ktortop/Lightmeter/PCB Layout/docs/render_3d.png

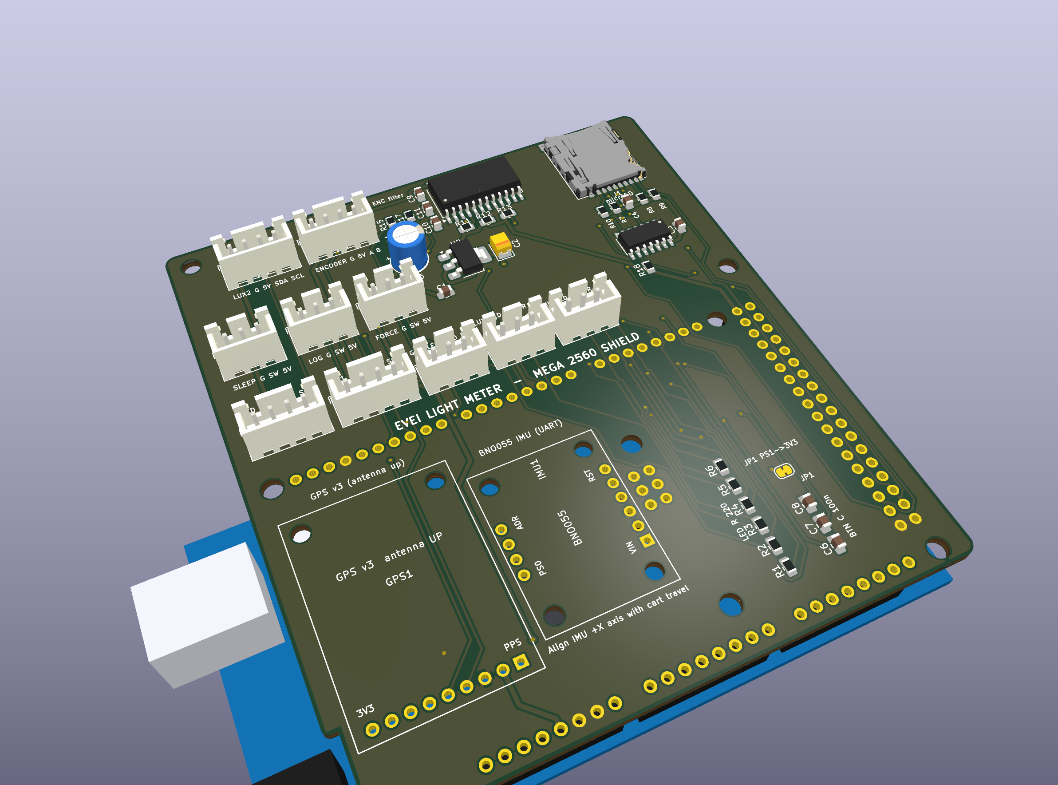
PCB Layout/docs/render_3d.png
