ktortop/Lightmeter/PCB Layout/docs/render_3d_bottom.png

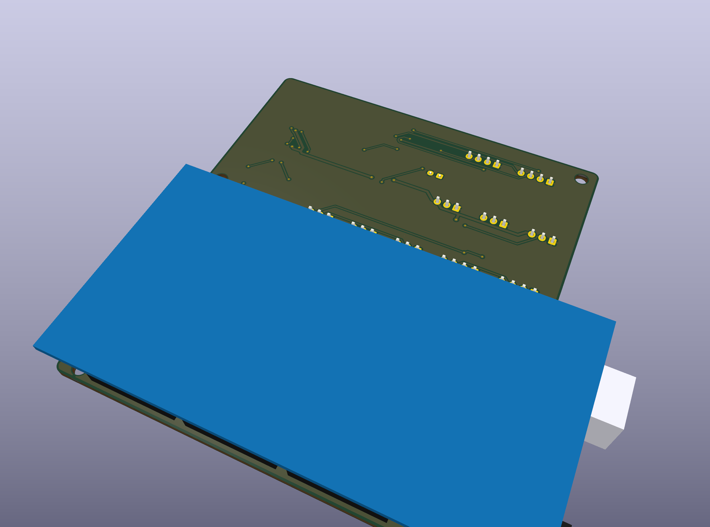
PCB Layout/docs/render_3d_bottom.png
