ktortop/Lightmeter/PCB Layout/docs/render_bottom.png

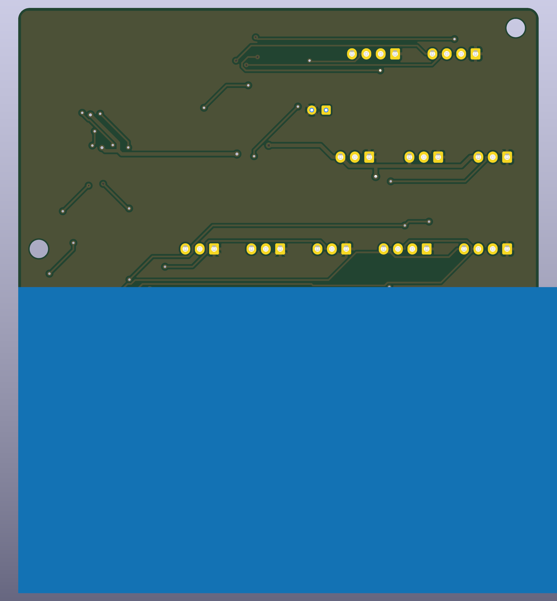
PCB Layout/docs/render_bottom.png
