ktortop/Lightmeter/PCB Layout/docs/render_top.png

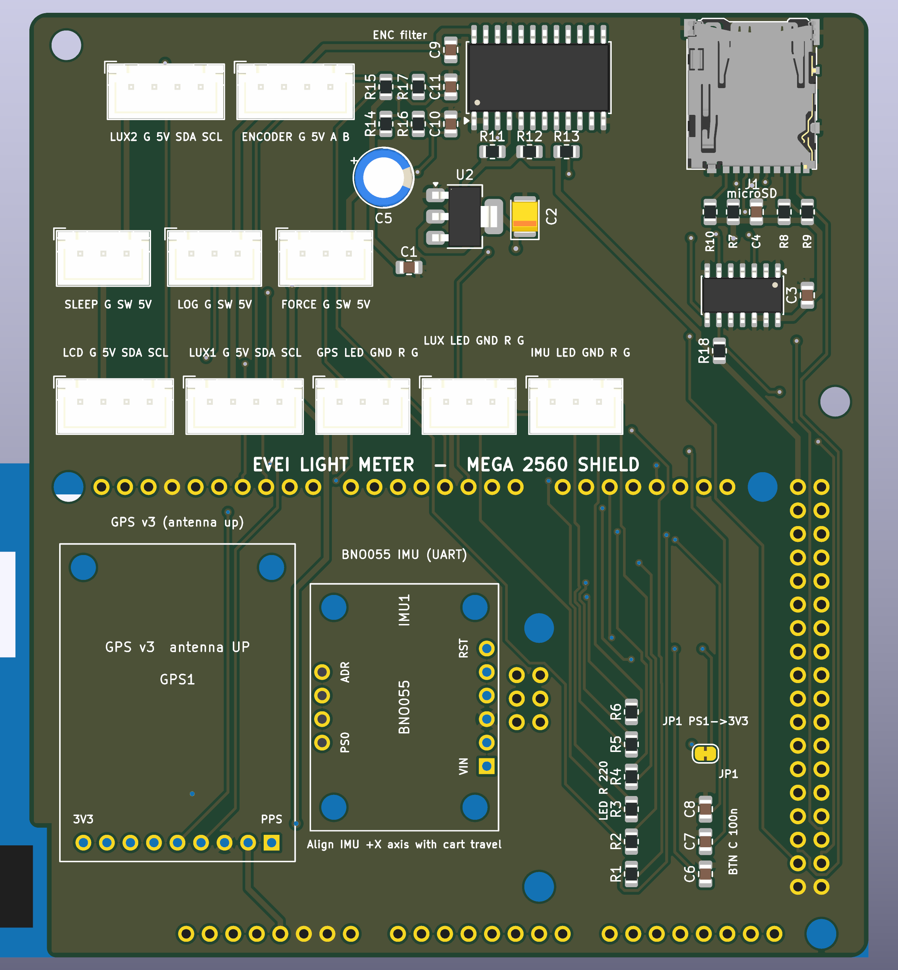
PCB Layout/docs/render_top.png
