ktortop/Lightmeter/Week12_Readings/map_nov12.jpg

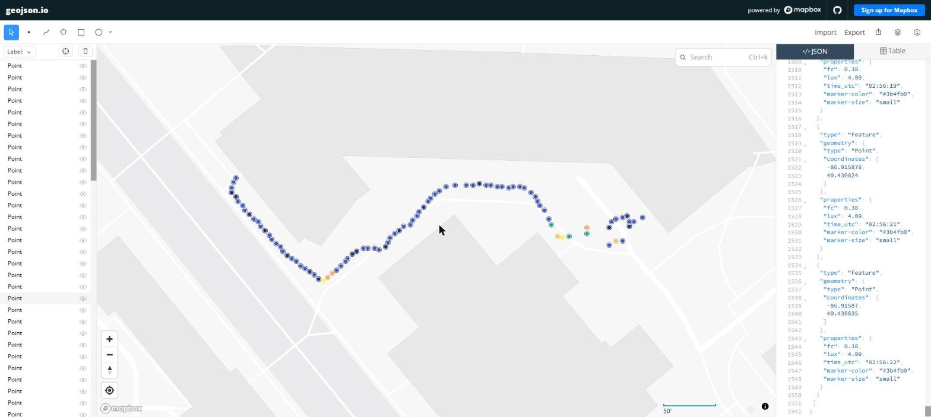
Week12_Readings/map_nov12.jpg
