ktortop/Lightmeter/PCB Layout/docs/BOM.csv

Refs | Value | Footprint | Description | Qty
A1 | Arduino Mega 2560 R3 | LightMeter:Arduino_Mega2560_Shield | Arduino Mega 2560 (shield headers, board plugs on top) | 1
C1 | 10uF | Capacitor_SMD:C_0805_2012Metric | LDO input | 1
C2 | 22uF tantalum 10V | Capacitor_Tantalum_SMD:CP_EIA-3528-21_Kemet-B | LDO output; tantalum ESR keeps AMS1117 stable | 1
C3,C4,C6-C9 | 100nF | Capacitor_SMD:C_0805_2012Metric | BTN force debounce,BTN log debounce,BTN sleep debounce,SD VDD decoupling,U1 decoupling,U3 decoupling | 6
C5 | 100uF/16V | Capacitor_THT:CP_Radial_D6.3mm_P2.50mm | 5V bulk, 6.3 mm radial, 2.5 mm pitch (5 mm parts fit too) | 1
C10,C11 | 1nF | Capacitor_SMD:C_0805_2012Metric | encoder A filter, 1 us with R16,encoder B filter | 2
GPS1 | Adafruit Ultimate GPS v3 (746) | LightMeter:Adafruit_UltimateGPS_v3 | GPS breakout soldered to board via 1x9 header | 1
IMU1 | Adafruit BNO055 (2472) | LightMeter:Adafruit_BNO055_2472 | IMU breakout soldered to board, UART mode | 1
J1 | microSD DM3AT-SF-PEJM5 | Connector_Card:microSD_HC_Hirose_DM3AT-SF-PEJM5 | microSD socket, push-push | 1
J2 | LCD 20x4 I2C | Connector_JST:JST_XH_B4B-XH-A_1x04_P2.50mm_Vertical | JST-XH 4p: GND 5V SDA SCL | 1
J3 | LUX1 TSL2591 | Connector_JST:JST_XH_B4B-XH-A_1x04_P2.50mm_Vertical | JST-XH 4p: GND 5V SDA SCL | 1
J4 | LED1 GPS | Connector_JST:JST_XH_B3B-XH-A_1x03_P2.50mm_Vertical | JST-XH 3p: GND(common cathode) R G | 1
J5 | LED2 LUX | Connector_JST:JST_XH_B3B-XH-A_1x03_P2.50mm_Vertical | JST-XH 3p: GND(common cathode) R G | 1
J6 | LED3 IMU | Connector_JST:JST_XH_B3B-XH-A_1x03_P2.50mm_Vertical | JST-XH 3p: GND(common cathode) R G | 1
J7 | BTN SLEEP | Connector_JST:JST_XH_B3B-XH-A_1x03_P2.50mm_Vertical | JST-XH 3p: GND SW 5V(lamp) | 1
J8 | BTN LOG TOGGLE | Connector_JST:JST_XH_B3B-XH-A_1x03_P2.50mm_Vertical | JST-XH 3p: GND SW 5V(lamp) | 1
J9 | BTN FORCE LOG | Connector_JST:JST_XH_B3B-XH-A_1x03_P2.50mm_Vertical | JST-XH 3p: GND SW 5V(lamp) | 1
J10 | LUX2 TSL2591 | Connector_JST:JST_XH_B4B-XH-A_1x04_P2.50mm_Vertical | JST-XH 4p: GND 5V SDA SCL (behind I2C mux ch0) | 1
J11 | ENCODER | Connector_JST:JST_XH_B4B-XH-A_1x04_P2.50mm_Vertical | JST-XH 4p: GND 5V A B, quadrature encoder | 1
R1-R6 | 220 | Resistor_SMD:R_0805_2012Metric | LED1 green series,LED1 red series,LED2 green series,LED2 red series,LED3 green series,LED3 red series | 6
R7-R15,R18 | 10k | Resistor_SMD:R_0805_2012Metric | LUX2 SCL pull-up,LUX2 SDA pull-up,SD CS pull-up,SD CS pull-up, Mega side (card deselected during reset),SD DAT0/MISO pull-up,SD DAT1 pull-up,SD DAT2 pull-up,encoder A pull-up (open-collector outputs),encoder B pull-up,mux RESET pull-up | 10
R16,R17 | 1k | Resistor_SMD:R_0805_2012Metric | encoder A series (filter + pin protection),encoder B series | 2
U1 | 74LVC125A | Package_SO:SOIC-14_3.9x8.7mm_P1.27mm | 5V->3.3V level shifter for SD MOSI/SCK/CS | 1
U2 | AMS1117-3.3 | Package_TO_SOT_SMD:SOT-223-3_TabPin2 | 3.3V LDO for microSD | 1
U3 | PCA9548AD (SOIC-24W) | Package_SO:SOIC-24W_7.5x15.4mm_P1.27mm | I2C mux, addr 0x70; ch0 = second TSL2591 (same 0x29 address) | 1
