ktortop/Lightmeter/PCB Layout/docs/LightMeter_MegaShield.step

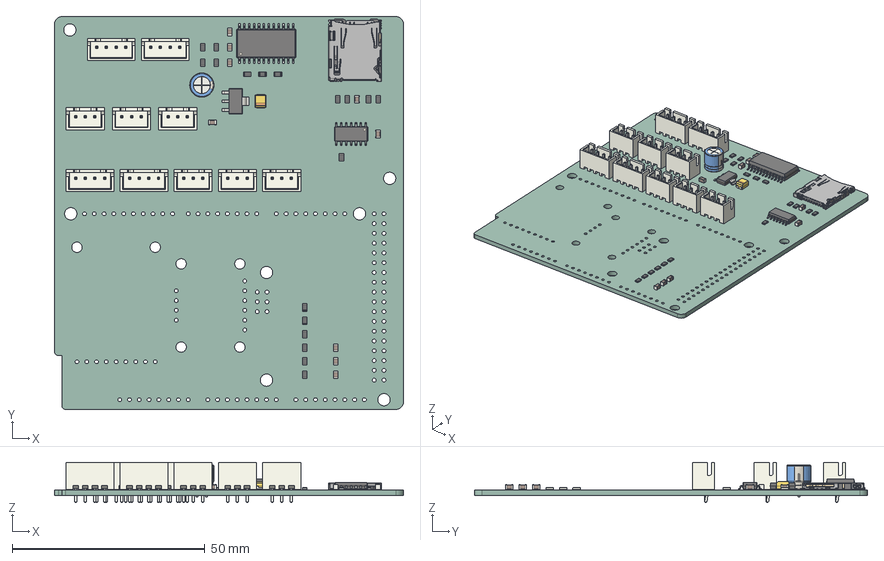
[picture p6: CAD file, 2026-10-30]
PCB Layout/docs/LightMeter_MegaShield.step
90.6 x 102.0 x 10.4 mm
C_0805_2012Metric x 9
R_0805_2012Metric x 18
JST_B4B_XH_A x 4
JST_B3B_XH_A x 6
CP_Radial_D63mm_P250mm
SOT-223
SOIC-14_3.9x8.7mm_P1.27mm
microSD_HC_Hirose_DM3AT-SF-PEJM5
SOIC-24W_7.5x15.4mm_P1.27mm
CP_EIA_3528_21_Kemet_B
nostep_tmp_PCB
