ktortop/Lightmeter/PCB Layout/archive/revA/docs/LightMeter_MegaShield.step

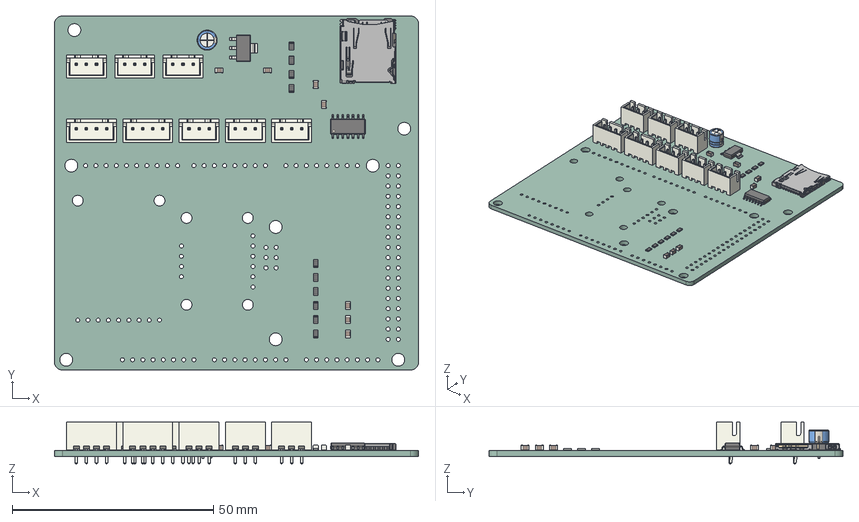
[picture p7: CAD file, 2026-10-29, an earlier design]
PCB Layout/archive/revA/docs/LightMeter_MegaShield.step
90.6 x 88.0 x 10.4 mm
R_0805_2012Metric x 10
SOIC-14_3.9x8.7mm_P1.27mm
JST_B4B_XH_A x 2
JST_B3B_XH_A x 6
C_0805_2012Metric x 7
microSD_HC_Hirose_DM3AT-SF-PEJM5
CP_Radial_D50mm_P200mm
SOT-223
nostep_tmp_PCB
