ktortop/Lightmeter/test_readings_oct29/lightmeter_20261029_202630.csv

date_yyyy-mm-dd | time_utc | fc | lat | lon | pc_time
2026-10-30 | 00:26:45 | nan | 40.430976 | -86.916000 | 2026-10-29T20:26:46
2026-10-30 | 00:26:53 | nan | 40.431007 | -86.916030 | 2026-10-29T20:26:53
2026-10-30 | 00:26:57 | nan | 40.431007 | -86.915992 | 2026-10-29T20:26:57
2026-10-30 | 00:27:06 | nan | 40.430976 | -86.916091 | 2026-10-29T20:27:06
2026-10-30 | 00:27:08 | 0.76 | 40.430957 | -86.916114 | 2026-10-29T20:27:08
2026-10-30 | 00:27:10 | 0.38 | 40.430942 | -86.916114 | 2026-10-29T20:27:11
2026-10-30 | 00:27:13 | 0.76 | 40.430919 | -86.916107 | 2026-10-29T20:27:14
2026-10-30 | 00:27:15 | 0.76 | 40.430904 | -86.916091 | 2026-10-29T20:27:15
2026-10-30 | 00:27:16 | 2.32 | 40.430892 | -86.916076 | 2026-10-29T20:27:17
2026-10-30 | 00:27:18 | 1.95 | 40.430885 | -86.916061 | 2026-10-29T20:27:18
2026-10-30 | 00:27:21 | 0.00 | 40.430873 | -86.916046 | 2026-10-29T20:27:21
2026-10-30 | 00:27:22 | 0.00 | 40.430862 | -86.916038 | 2026-10-29T20:27:23
2026-10-30 | 00:27:24 | 0.38 | 40.430850 | -86.916030 | 2026-10-29T20:27:25
2026-10-30 | 00:27:26 | 0.38 | 40.430839 | -86.916015 | 2026-10-29T20:27:26
2026-10-30 | 00:27:27 | nan | 40.430828 | -86.916000 | 2026-10-29T20:27:27
2026-10-30 | 00:27:28 | 0.38 | 40.430820 | -86.915985 | 2026-10-29T20:27:28
2026-10-30 | 00:27:29 | 0.38 | 40.430809 | -86.915977 | 2026-10-29T20:27:29
2026-10-30 | 00:27:30 | nan | 40.430797 | -86.915962 | 2026-10-29T20:27:31
2026-10-30 | 00:27:33 | nan | 40.430782 | -86.915962 | 2026-10-29T20:27:33
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
2026-10-30 | 00:31:21 | 0.00 | 40.428813 | -86.913955 | 2026-10-29T20:31:22
2026-10-30 | 00:31:23 | nan | 40.428806 | -86.913940 | 2026-10-29T20:31:23
2026-10-30 | 00:31:24 | 0.38 | 40.428794 | -86.913925 | 2026-10-29T20:31:24
2026-10-30 | 00:31:25 | 0.00 | 40.428791 | -86.913909 | 2026-10-29T20:31:25
2026-10-30 | 00:31:26 | nan | 40.428783 | -86.913894 | 2026-10-29T20:31:27
2026-10-30 | 00:31:28 | 0.00 | 40.428775 | -86.913871 | 2026-10-29T20:31:28
2026-10-30 | 00:31:29 | 0.38 | 40.428771 | -86.913856 | 2026-10-29T20:31:30
2026-10-30 | 00:31:30 | nan | 40.428764 | -86.913841 | 2026-10-29T20:31:31
2026-10-30 | 00:31:32 | nan | 40.428756 | -86.913825 | 2026-10-29T20:31:32
