ktortop/Lightmeter/test_readings_oct29/map_stadium_mall.png

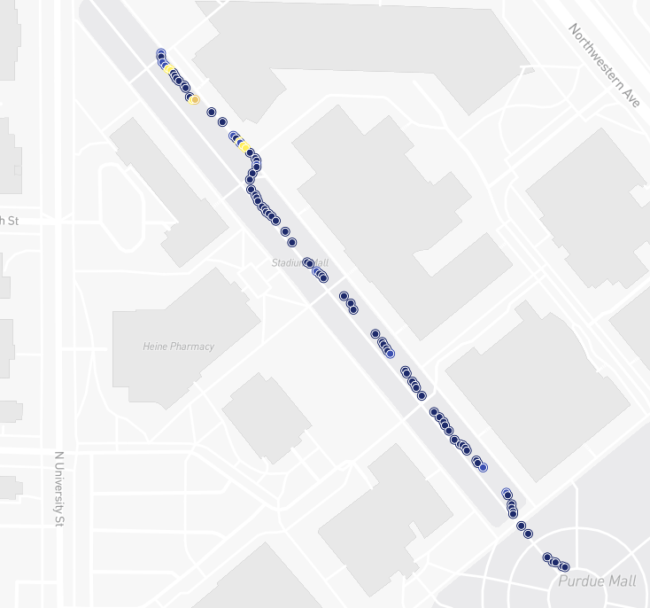
test_readings_oct29/map_stadium_mall.png
