ktortop/Lightmeter/PCB Layout/archive/revA/docs/pcb_bottom.pdf

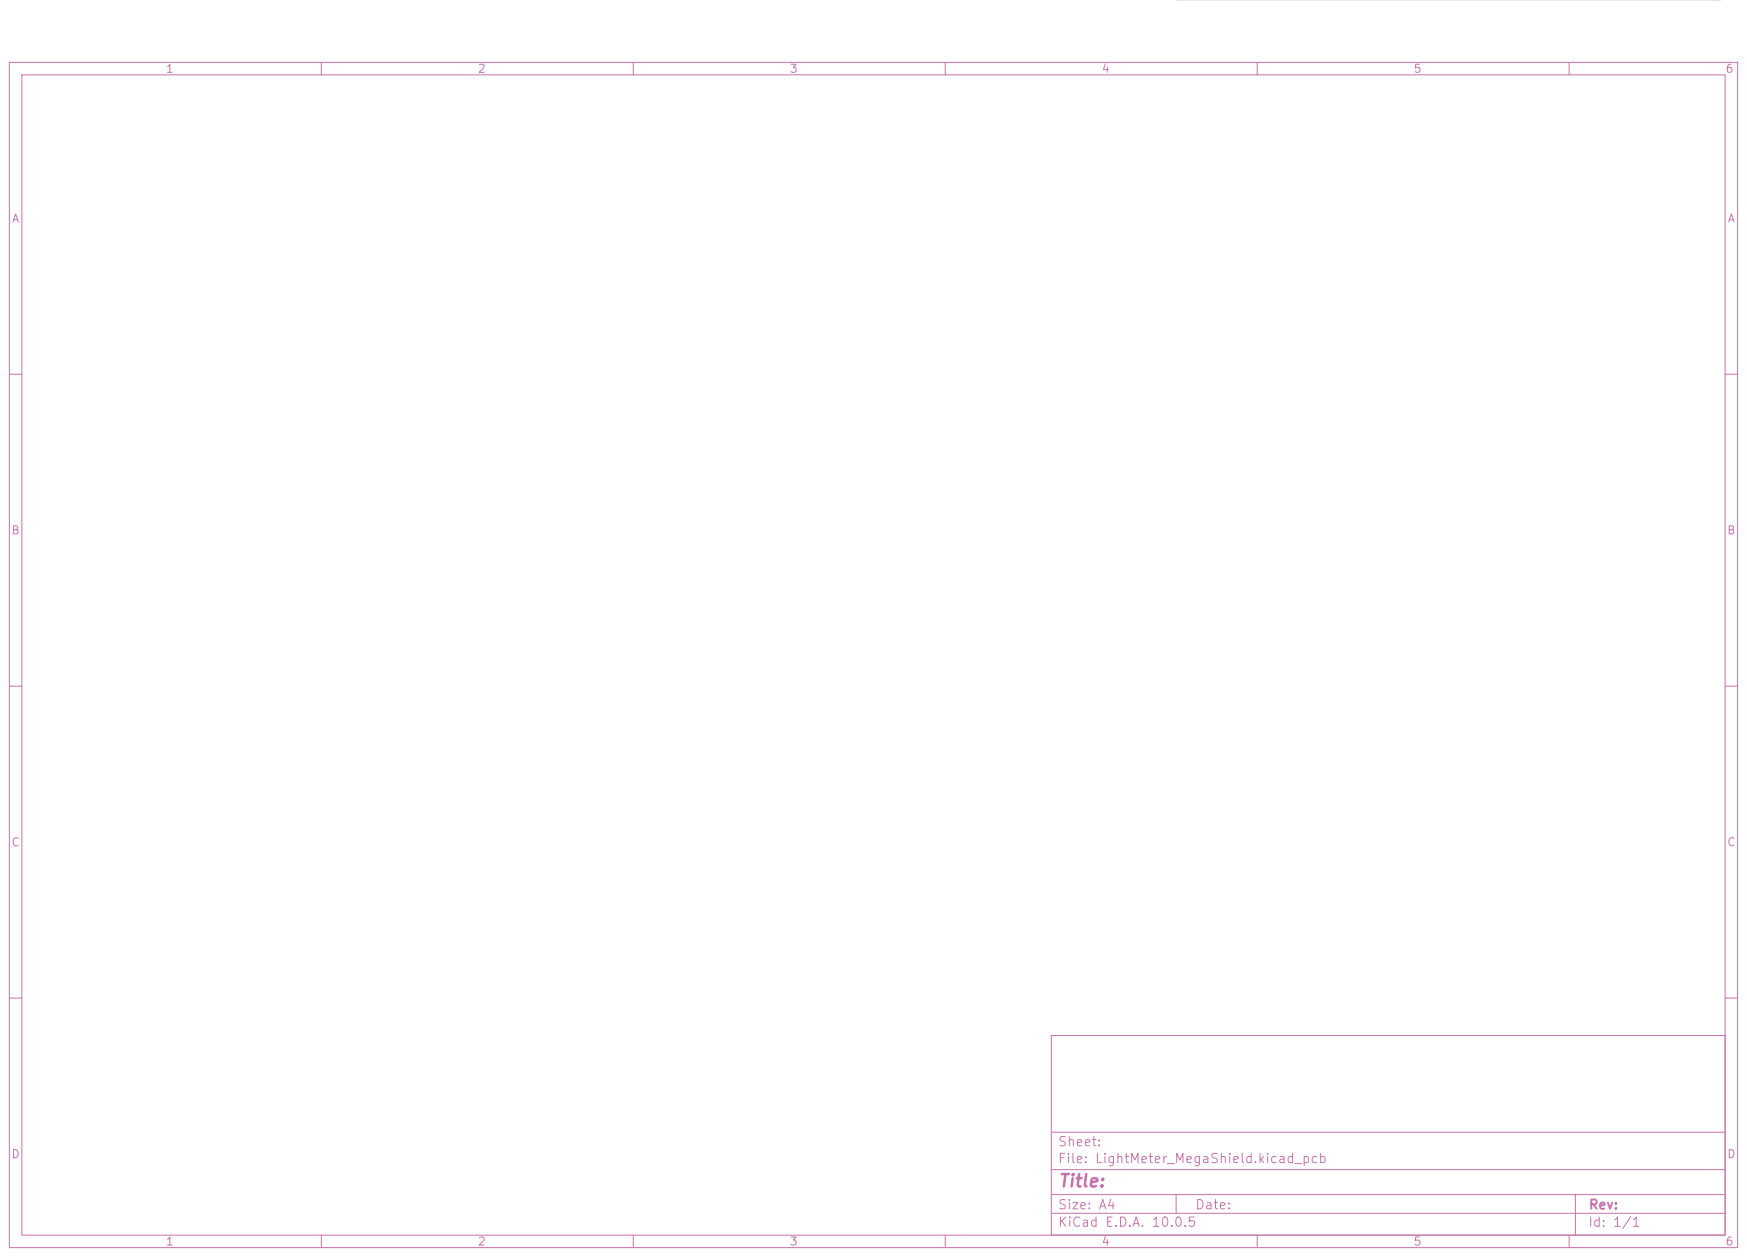
[picture p12: page 1]

Size: A4 | Rev:
KiCad E.D.A. 10.0.5 | Id: 1/1
