ktortop/Lightmeter/PCB Layout/kicad/LightMeter_MegaShield.kicad_pcb

## KiCad design PCB Layout/kicad/LightMeter_MegaShield.kicad_pcb (2026-10-30)

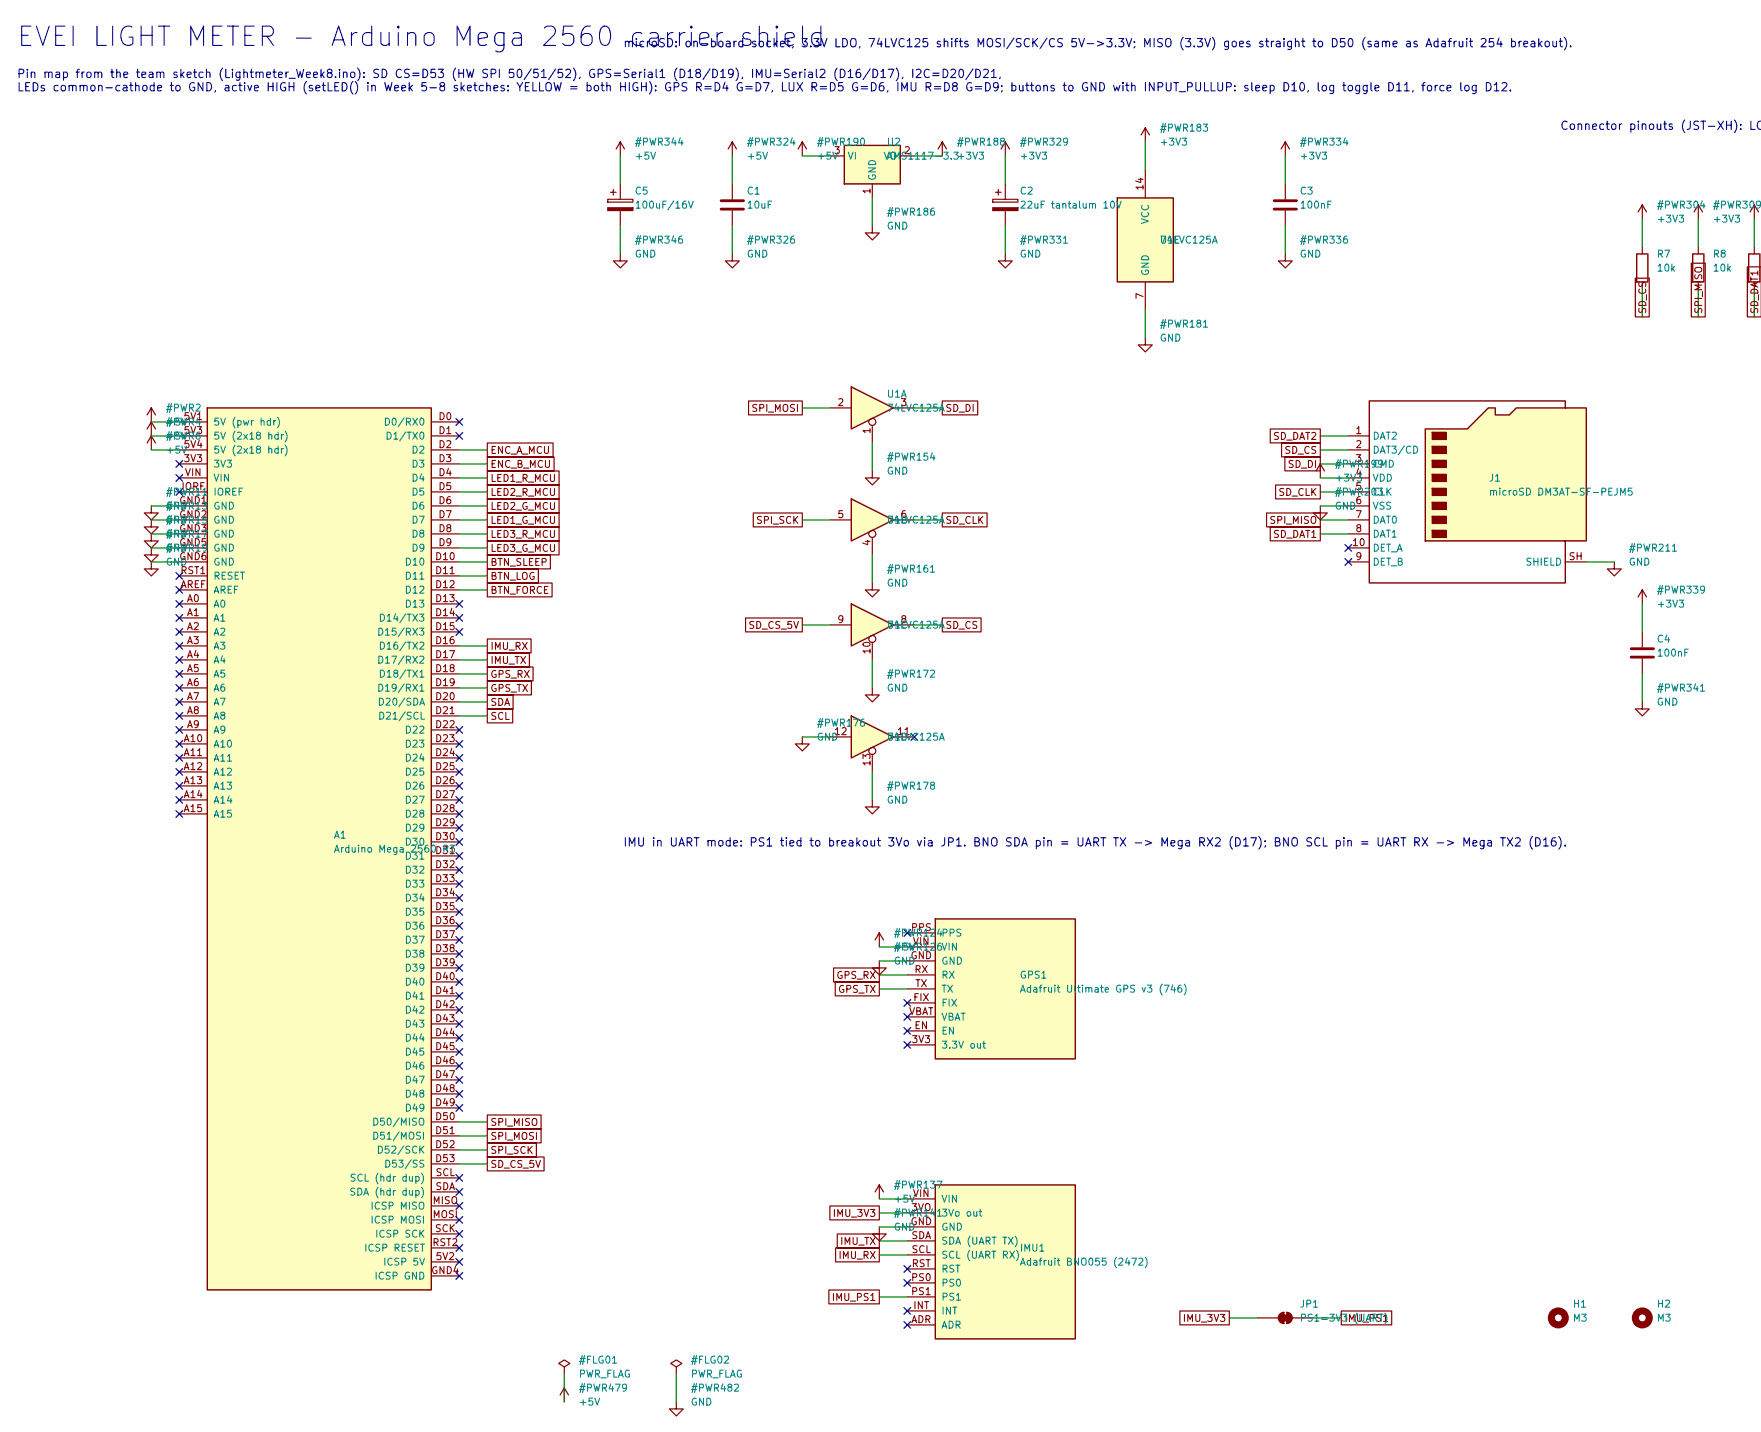
[picture p14: schematic LightMeter_MegaShield.kicad_sch, EVEI Light Meter - Mega 2560 Shield, part in row 1, column 1]

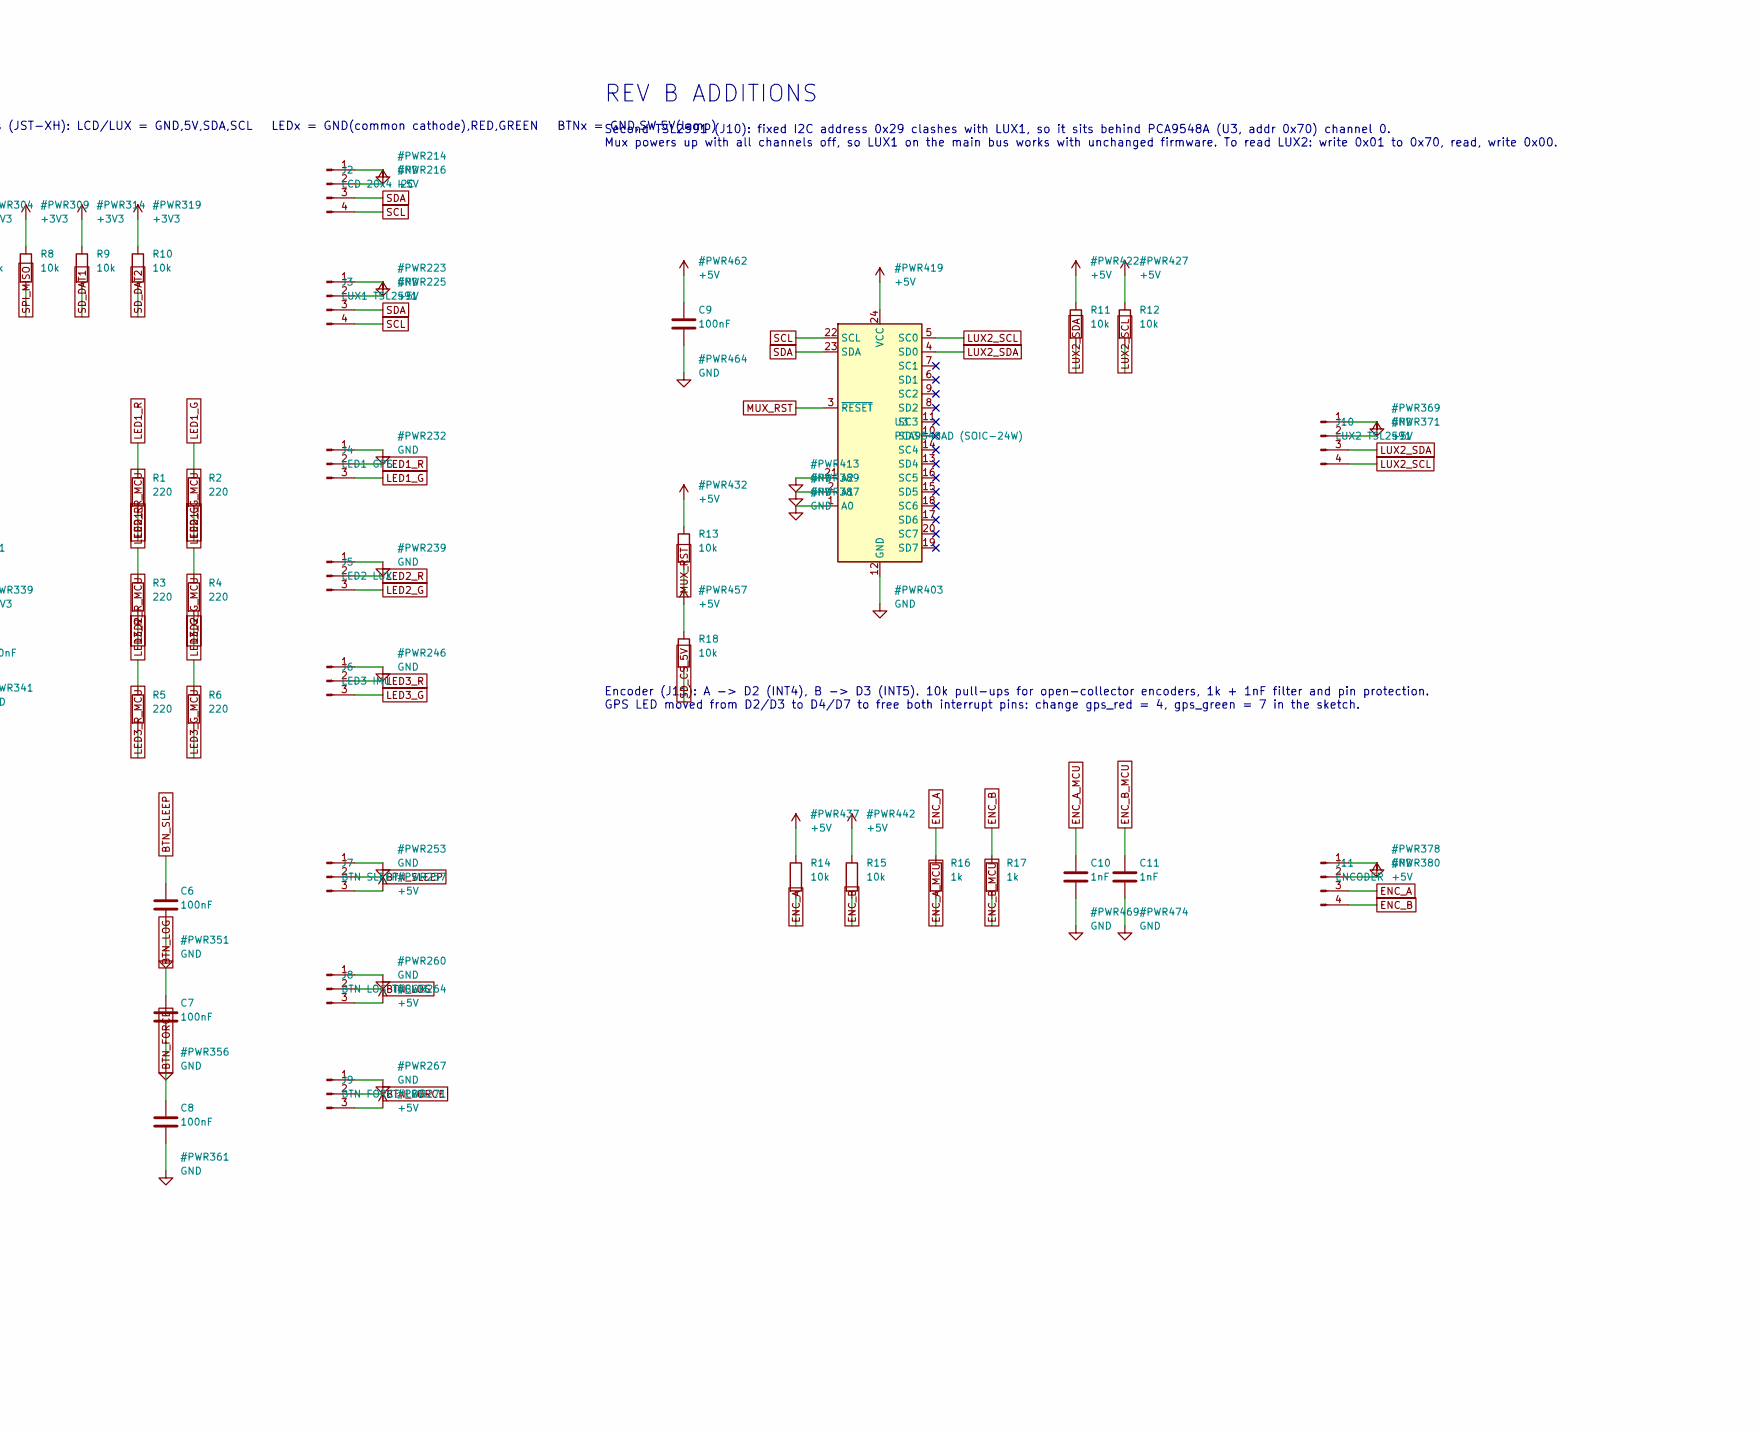
[picture p15: schematic LightMeter_MegaShield.kicad_sch, EVEI Light Meter - Mega 2560 Shield, part in row 1, column 2]

Parts:
A1: Arduino Mega 2560 R3; Arduino_Mega2560_Shield
C1: 10uF; C_0805_2012Metric
C2: 22uF tantalum 10V; CP_EIA-3528-21_Kemet-B
C3, C4, C6, C7, C8, C9: 100nF; C_0805_2012Metric
C5: 100uF/16V; CP_Radial_D6.3mm_P2.50mm
C10, C11: 1nF; C_0805_2012Metric
GPS1: Adafruit Ultimate GPS v3 (746); Adafruit_UltimateGPS_v3
H1, H2: M3; MountingHole_3.2mm_M3
IMU1: Adafruit BNO055 (2472); Adafruit_BNO055_2472
J1: microSD DM3AT-SF-PEJM5; microSD_HC_Hirose_DM3AT-SF-PEJM5
J2: LCD 20x4 I2C; JST_XH_B4B-XH-A_1x04_P2.50mm_Vertical
J3: LUX1 TSL2591; JST_XH_B4B-XH-A_1x04_P2.50mm_Vertical
J4: LED1 GPS; JST_XH_B3B-XH-A_1x03_P2.50mm_Vertical
J5: LED2 LUX; JST_XH_B3B-XH-A_1x03_P2.50mm_Vertical
J6: LED3 IMU; JST_XH_B3B-XH-A_1x03_P2.50mm_Vertical
J7: BTN SLEEP; JST_XH_B3B-XH-A_1x03_P2.50mm_Vertical
J8: BTN LOG TOGGLE; JST_XH_B3B-XH-A_1x03_P2.50mm_Vertical
J9: BTN FORCE LOG; JST_XH_B3B-XH-A_1x03_P2.50mm_Vertical
J10: LUX2 TSL2591; JST_XH_B4B-XH-A_1x04_P2.50mm_Vertical
J11: ENCODER; JST_XH_B4B-XH-A_1x04_P2.50mm_Vertical
JP1: PS1=3V3 (UART); SolderJumper-2_P1.3mm_Bridged_RoundedPad1.0x1.5mm
R1, R2, R3, R4, R5, R6: 220; R_0805_2012Metric
R7, R8, R9, R10, R11, R12, R13, R14, R15, R18: 10k; R_0805_2012Metric
R16, R17: 1k; R_0805_2012Metric
U1: 74LVC125A; SOIC-14_3.9x8.7mm_P1.27mm
U2: AMS1117-3.3; SOT-223-3_TabPin2
U3: PCA9548AD (SOIC-24W); SOIC-24W_7.5x15.4mm_P1.27mm

Connections:
+3V3: C2.1, C3.1, C4.1, J1.4 (VDD), R7.1, R8.1, R9.1, R10.1, U1.14 (VCC), U2.2 (VO)
+5V: A1.5V1 (5V (pwr hdr)), A1.5V3 (5V (2x18 hdr)), A1.5V4 (5V (2x18 hdr)), C1.1, C5.1, C9.1, GPS1.VIN, IMU1.VIN, J2.2, J3.2, J7.3, J8.3, J9.3, J10.2, J11.2, R11.1, R12.1, R13.1, R14.1, R15.1, R18.1, U2.3 (VI), U3.24 (VCC)
BTN_FORCE: A1.D12, C8.1, J9.2
BTN_LOG: A1.D11, C7.1, J8.2
BTN_SLEEP: A1.D10, C6.1, J7.2
ENC_A: J11.3, R14.2, R16.1
ENC_A_MCU: A1.D2, C10.1, R16.2
ENC_B: J11.4, R15.2, R17.1
ENC_B_MCU: A1.D3, C11.1, R17.2
GND: A1.GND1 (GND), A1.GND2 (GND), A1.GND3 (GND), A1.GND5 (GND), A1.GND6 (GND), C1.2, C2.2, C3.2, C4.2, C5.2, C6.2, C7.2, C8.2, C9.2, C10.2, C11.2, GPS1.GND, IMU1.GND, J1.6 (VSS), J1.SH (SHIELD), J2.1, J3.1, J4.1, J5.1, J6.1, J7.1, J8.1, J9.1, J10.1, J11.1, U1.1, U1.4, U1.7 (GND), U1.10, U1.12, U1.13, U2.1 (GND), U3.1 (A0), U3.2 (A1), U3.12 (GND), U3.21 (A2)
GPS_RX: A1.D18 (D18/TX1), GPS1.RX
GPS_TX: A1.D19 (D19/RX1), GPS1.TX
IMU_3V3: IMU1.3VO (3Vo out), JP1.1 (A)
IMU_PS1: IMU1.PS1, JP1.2 (B)
IMU_RX: A1.D16 (D16/TX2), IMU1.SCL (SCL (UART RX))
IMU_TX: A1.D17 (D17/RX2), IMU1.SDA (SDA (UART TX))
LED1_G: J4.3, R2.1
LED1_G_MCU: A1.D7, R2.2
LED1_R: J4.2, R1.1
LED1_R_MCU: A1.D4, R1.2
LED2_G: J5.3, R4.1
LED2_G_MCU: A1.D6, R4.2
LED2_R: J5.2, R3.1
LED2_R_MCU: A1.D5, R3.2
LED3_G: J6.3, R6.1
LED3_G_MCU: A1.D9, R6.2
LED3_R: J6.2, R5.1
LED3_R_MCU: A1.D8, R5.2
LUX2_SCL: J10.4, R12.2, U3.5 (SC0)
LUX2_SDA: J10.3, R11.2, U3.4 (SD0)
MUX_RST: R13.2, U3.3 (~RESET)
SCL: A1.D21 (D21/SCL), J2.4, J3.4, U3.22 (SCL)
SDA: A1.D20 (D20/SDA), J2.3, J3.3, U3.23 (SDA)
SD_CLK: J1.5 (CLK), U1.6
SD_CS: J1.2 (DAT3/CD), R7.2, U1.8
SD_CS_5V: A1.D53 (D53/SS), R18.2, U1.9
SD_DAT1: J1.8 (DAT1), R9.2
SD_DAT2: J1.1 (DAT2), R10.2
SD_DI: J1.3 (CMD), U1.3
SPI_MISO: A1.D50 (D50/MISO), J1.7 (DAT0), R8.2
SPI_MOSI: A1.D51 (D51/MOSI), U1.2
SPI_SCK: A1.D52 (D52/SCK), U1.5

Notes on the sheet:
EVEI LIGHT METER - Arduino Mega 2560 carrier shield
Pin map from the team sketch (Lightmeter_Week8.ino): SD CS=D53 (HW SPI 50/51/52), GPS=Serial1 (D18/D19), IMU=Serial2 (D16/D17), I2C=D20/D21, LEDs common-cathode to GND, active HIGH (setLED() in Week 5-8 sketches: YELLOW = both HIGH): GPS R=D4 G=D7, LUX R=D5 G=D6, IMU R=D8 G=D9; buttons to GND with 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
microSD: on-board socket, 3.3V LDO, 74LVC125 shifts MOSI/SCK/CS 5V->3.3V; MISO (3.3V) goes straight to D50 (same as Adafruit 254 breakout).
IMU in UART mode: PS1 tied to breakout 3Vo via JP1. BNO SDA pin = UART TX -> Mega RX2 (D17); BNO SCL pin = UART RX -> Mega TX2 (D16).
REV B ADDITIONS
Second TSL2591 (J10): fixed I2C address 0x29 clashes with LUX1, so it sits behind PCA9548A (U3, addr 0x70) channel 0. Mux powers up with all channels off, so LUX1 on the main bus works with unchanged firmware. To read LUX2: write 0x01 to 0x70, read, write 0x00.
Encoder (J11): A -> D2 (INT4), B -> D3 (INT5). 10k pull-ups for open-collector encoders, 1k + 1nF filter and pin protection. GPS LED moved from D2/D3 to D4/D7 to free both interrupt pins: change gps_red = 4, gps_green = 7 in the sketch.
Connector pinouts (JST-XH): LCD/LUX = GND,5V,SDA,SCL LEDx = GND(common cathode),RED,GREEN BTNx = GND,SW,5V(lamp)

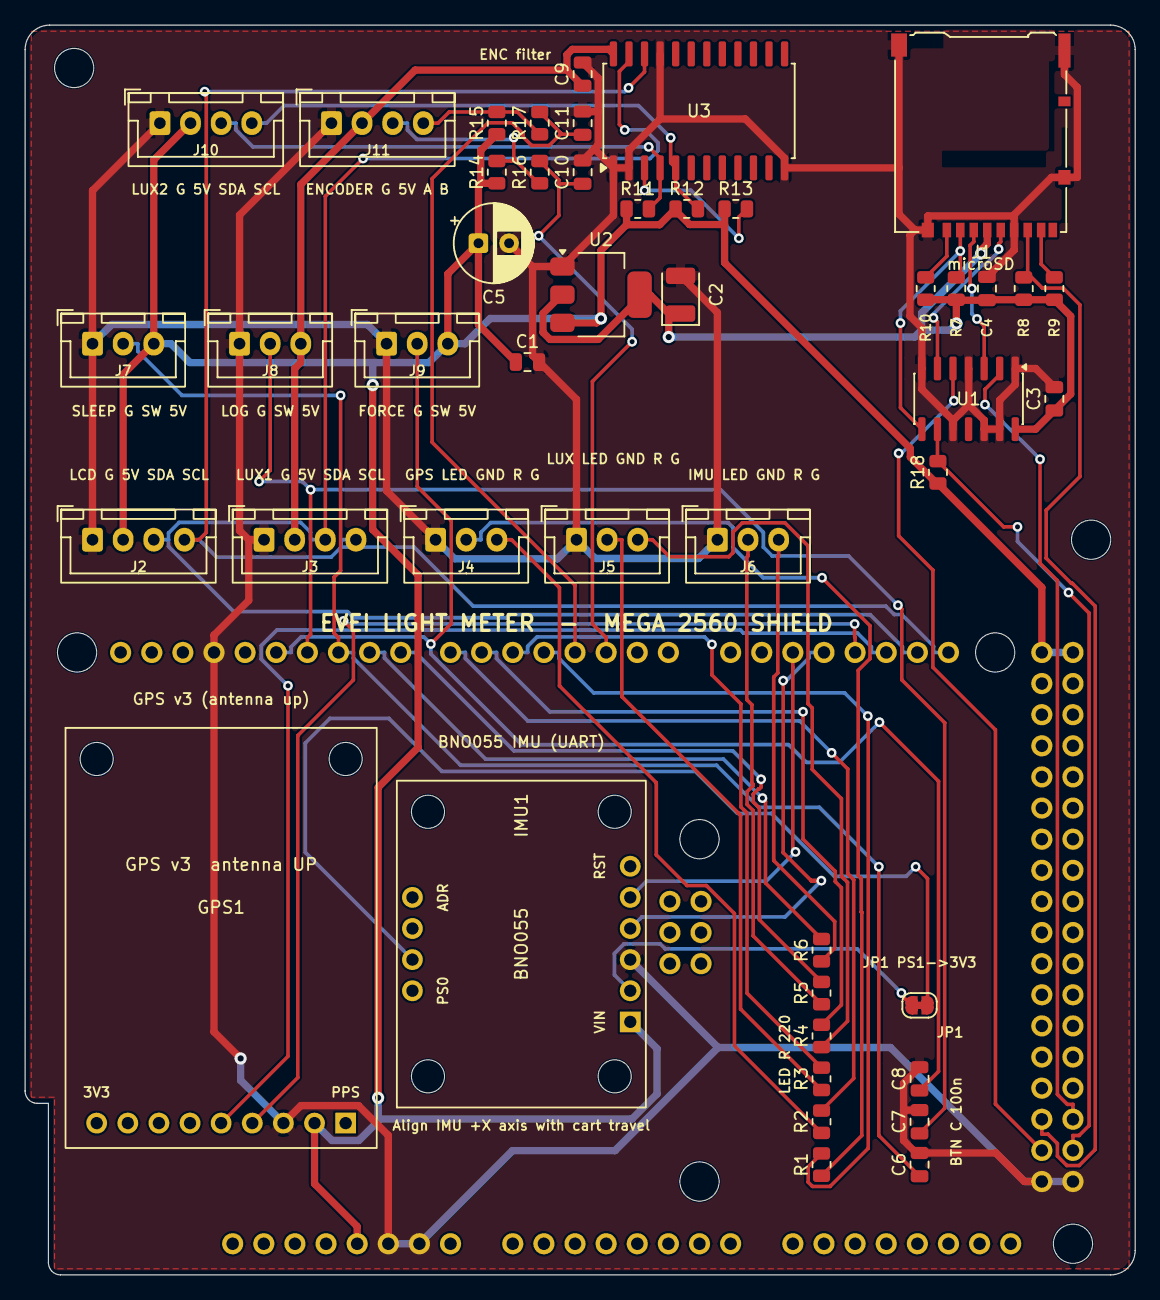
[picture p16: board LightMeter_MegaShield.kicad_pcb from above]

Board: 2 copper layers, 90.6 x 102.0 mm, 49 parts (0 on the bottom side), 42 nets.
