ktortop/Lightmeter/(commit log)

2026-02-01 Battery display - not tested
2026-02-01 Battery display - not tested V2
2026-02-12 some tweaks, didn't change anything
    [LightMeter2_BASIC.ino]
2026-02-12 LED code, commented out
2026-03-05 New Lux Sensor Code, not tested
2026-03-08 Just some naming conventions, lux sensor updating not tested yet
2026-03-25 if I broke anything I'll revert it
    [LightMeter2_BASIC.ino]
2026-10-16 Add Lightmeter Week 8
    Level check now uses roll only (pitch no longer blocks logging).
2026-10-29 Add PCB Layout: Arduino Mega 2560 shield for the light meter
    Two-layer KiCad shield with on-board GPS and microSD, JST connectors for
    the LCD, two lux sensors (second via PCA9548A mux), status LEDs, buttons
    and a motor encoder. Includes schematic, routed layout, OSH Park-ready
    Gerbers/drill zip, BOM, renders, STEP, generator scripts and rev A archive.
    ERC 0, DRC 0, schematic parity 0.
2026-10-29 PCB Layout: fix status-LED wiring for common-cathode LEDs, validation pass
    - LED connectors J4-J6: pin 1 is now GND (common cathode) and each *_red pin
    drives the red die, matching setLED() in the Week 5-8 sketches
    (HIGH = on, YELLOW = both HIGH). The old 5V/common-anode wiring would
    have swapped YELLOW and OFF with Week 8.
    GPS red D4 / green D7, LUX red D5 / green D6, IMU red D8 / green D9.
    - Rerouted; silkscreen now reads "GND R G"; Gerbers, drills, BOM, renders,
    schematic PDF and STEP regenerated. ERC 0, DRC 0, parity 0.
    - README: IMU orientation matters (Week 8 checks roll only), header
    trimming applies to GPS/IMU pins only, updated counts and boot sequence.
    - Verified GPS/BN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
2026-10-30 Add Week 8 No-SD version with USB logging, plus Oct 29 test readings
    Lightmeter_Week8_NoSD.ino is Week 8 with the SD card made optional:
    - SD failure no longer halts; every logged point is sent over USB as a
    "CSV," line (and still written to the card if one works)
    - 1 Hz STATUS line over USB (fix, sats, anchor, speed, sd, log)
    - I2C bus timeout so a dead/unpowered bus can't hang lcd.init() silently
    - Halts repeat their reason over USB every 3 s
    - IMU init retried up to 3 times (it failed once right after reset on the bench)
    tools/pc_logger.py saves the USB CSV lines to logs/ on the laptop.
    tools/export_arcgis.py converts logs to an ArcGIS Shapefile zip and GeoJSON.
    tools/hwdiag is a wirin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
2026-10-30 PCB Layout: assembly validation fixes
    - C5 bulk cap: 6.3 mm / 2.5 mm-pitch footprint (0.9 mm pad gap instead of
    0.4 mm between +5V and GND), moved clear of J9
    - microSD card-detect pad 9 left unconnected (0.25 mm from DAT1, a solder
    bridge there is now harmless)
    - no tracks/vias under screw heads and standoffs at every mounting hole;
    rerouted, ERC 0, DRC 0, parity 0, Gerbers/drills/zip regenerated
    - README: buy list, cable pinouts, LED/button mis-plug warning, GPS
    standoff method for the coin-cell holder, corrected power budget
2026-11-13 Add Lightmeter Week 12 (field-tested with working SD card)
    Lightmeter_Week12.ino is the version tested on Nov 12 2026 with every
    module working: IMU, GPS, TSL2591, LCD and the microSD card. Readings are
    written to datalog.csv on the card and also sent over USB.
    Code is the Week 8 No-SD version unchanged, plus a header documenting the SD
    setup: Adafruit MicroSD breakout board+ (product 254), powered from the Mega's
    3V3 pin, SPI on D50-D53. Notes that the 3V-only breakout (product 4682) does
    not work with the Mega's 5V signals.
    New SD tools:
    - tools/sddiag: checks whether the card answers its reset command
    - tools/sdcheck: lists files and runs a write/read-back test
    - tools/sddump + tools/sd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
